igor-salt/DC36_DC5/README.md

Герберы для Резонита - в папке GERBERS, для JLCPCD - в папке production.
Перечень элементов для информации - в файле DC36_DC5.csv, для загрузки в Платан - в DC36_DC5_PL.csv.
Выгрузка заказа на 10 плат из корзины Платана - platan.xls.
В PNG - скриншоты пробных заказов комплестующих и плат в Платане, Резоните и JLCPCB.

1. При установке подстроечного резистора RV1, не устанавливаются элементы поз. R1 R2 и наоборот.

2. При использовании U1 в исполнении на фиксированное выходное напряжение, не устанавливаются
 элементы поз. R1, R2, RV1, C4, а на место R2 устанавливается перемычка.

3. Посадочные места элементов D1, D2 допускают установку подходящих по параметрам диодов в корпусах
DPAK, D2PAK, SMB, SMC; D4 - SMB, SMC.

4. Посадочные места элементов С2, С5 - допускают установку подходящих по параметрам конденсаторов
в корпусах 8 и 10 мм.

5. Посадочное место L1 позволяет устанавливать дроссели типоразмеров от 10х10 до 18х18.
