igor-salt/DC36_DC5/JLCPCB.PNG

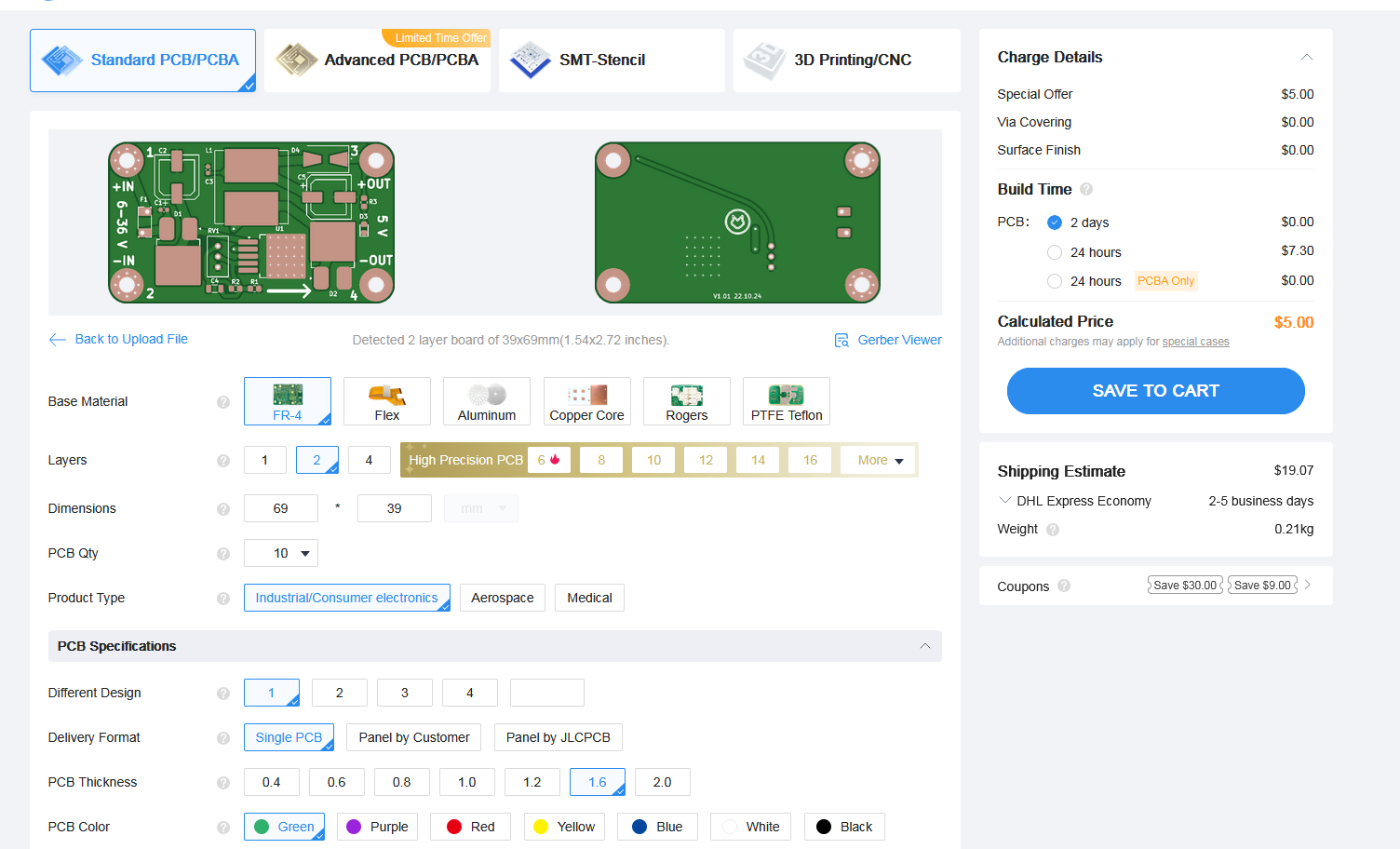
JLCPCB.PNG
