igor-salt/DC36_DC5/photo_2024-10-22_12-28-45.jpg

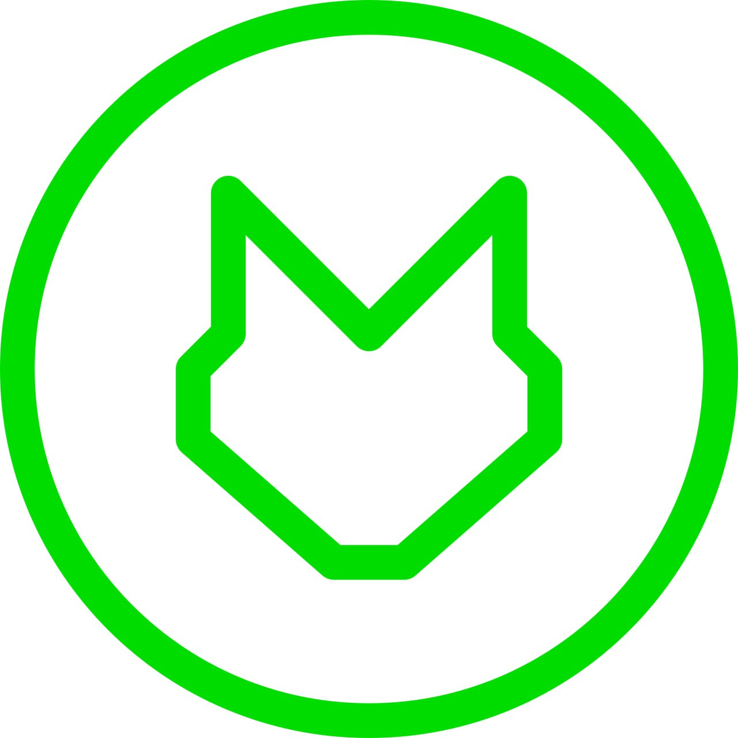
photo_2024-10-22_12-28-45.jpg
