igor-salt/DC36_DC5/Platan.PNG

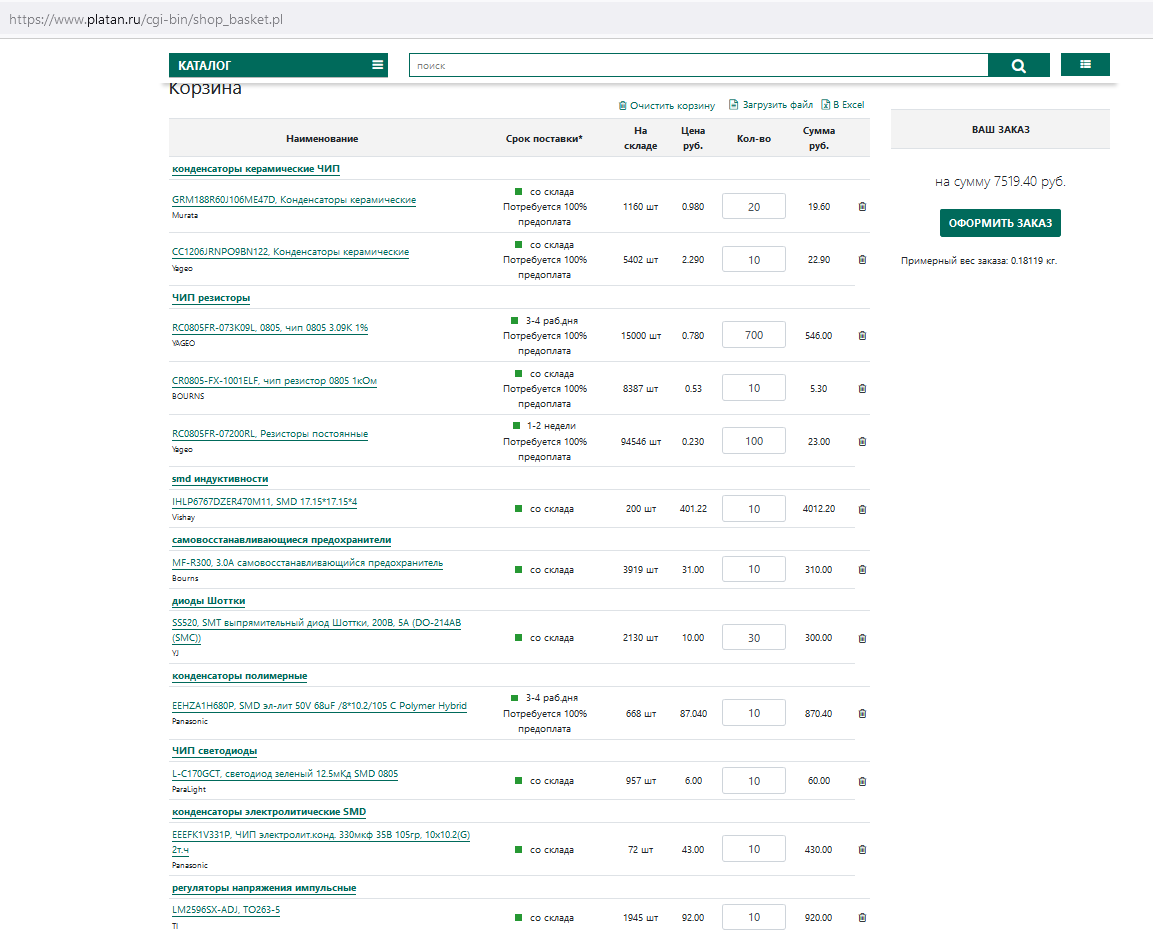
Platan.PNG
