igor-salt/DC36_DC5/rezonit.PNG

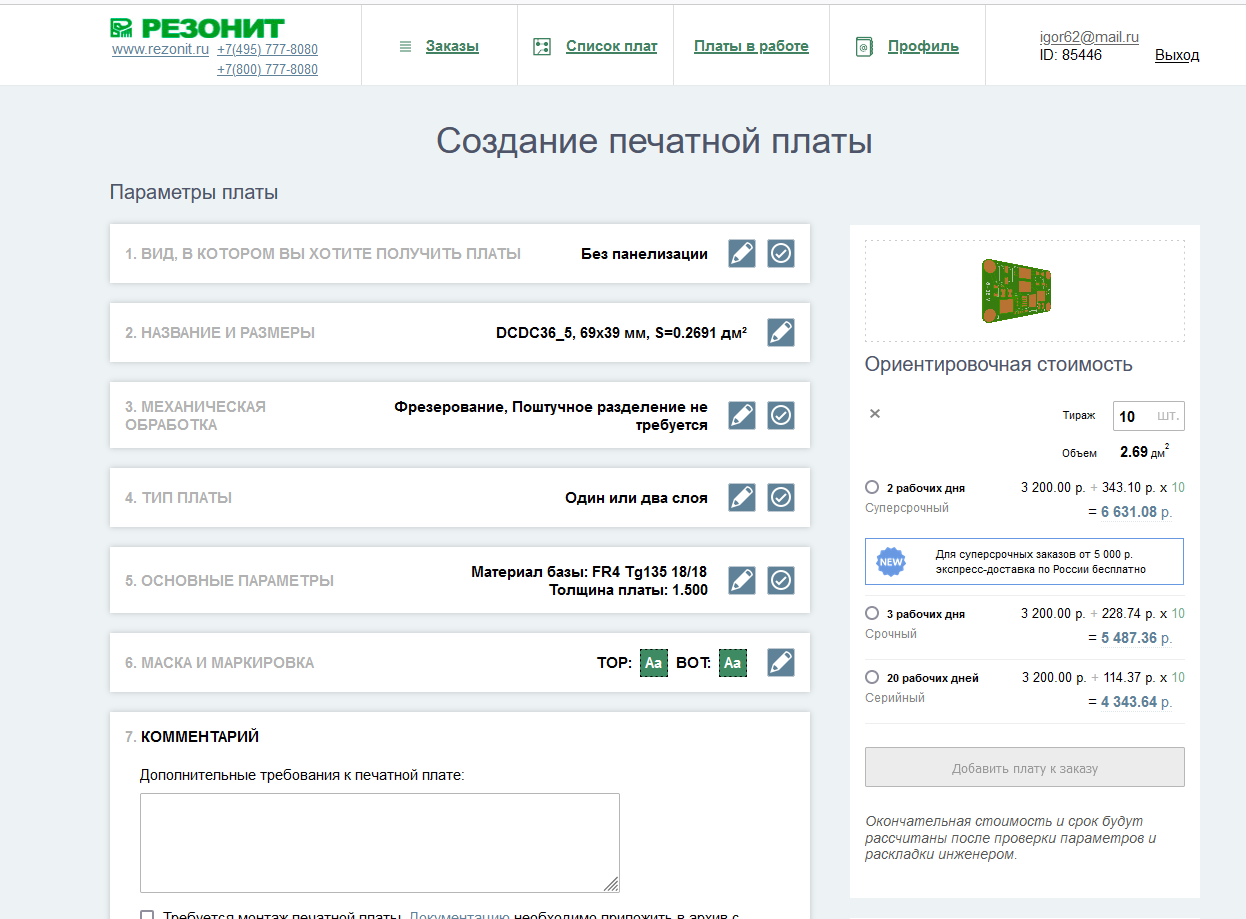
rezonit.PNG
