igor-salt/DC36_DC5/DC36_DC5.pdf

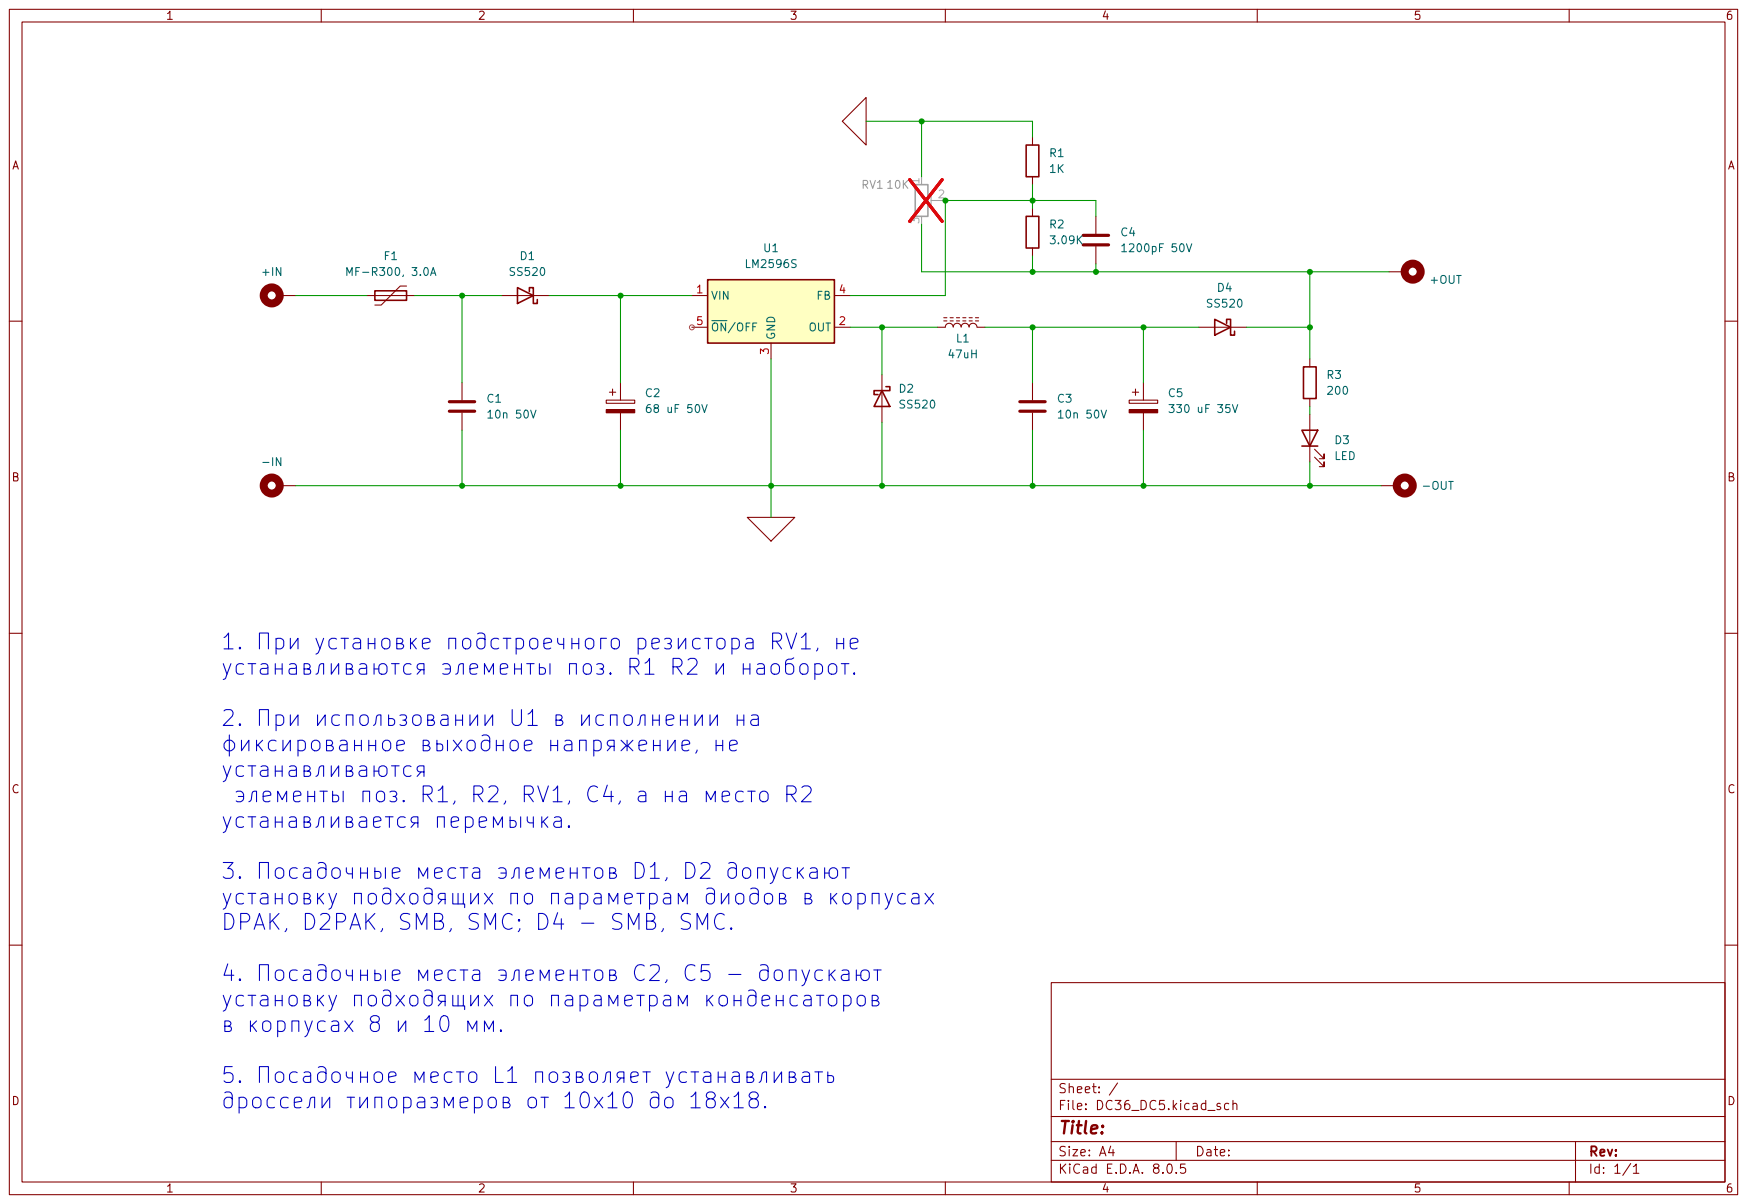
[picture p5: page 1]
