igor-salt/DC36_DC5/DC36_DC5.kicad_pcb

## KiCad design DC36_DC5.kicad_pcb (2024-10-22)

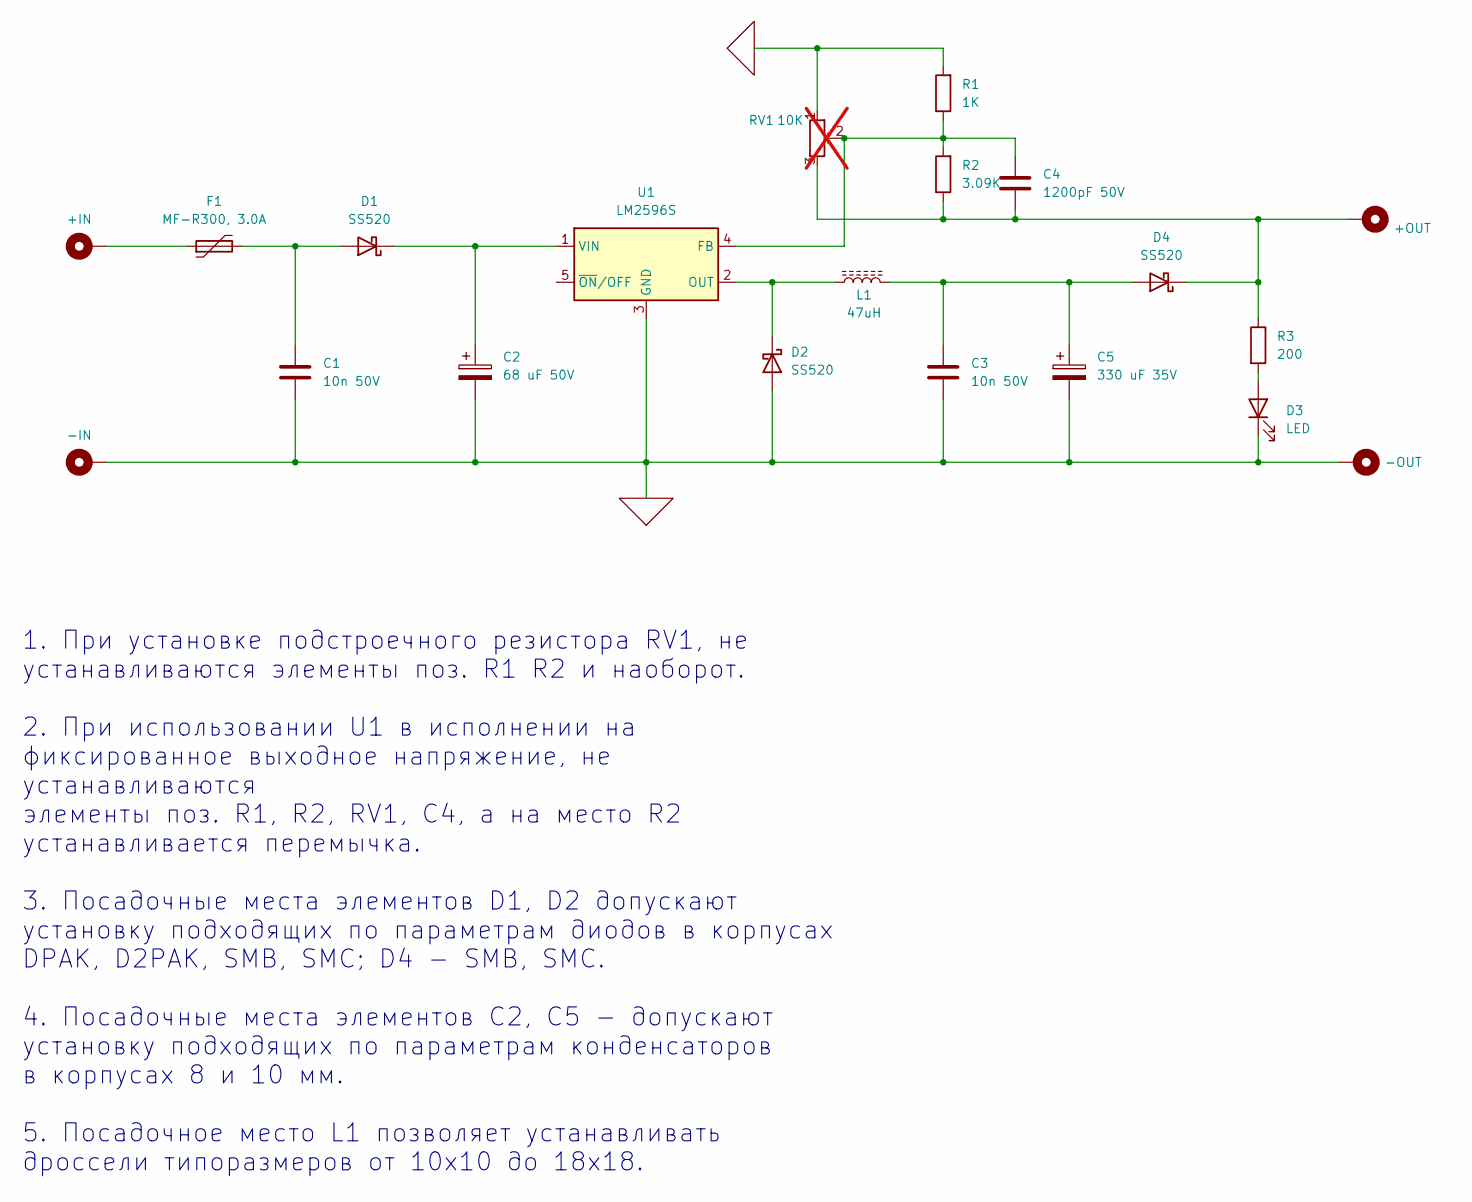
[picture p6: schematic DC36_DC5.kicad_sch]

Parts:
C1, C3: 10n 50V; C_0603_1608Metric
C2: 68 uF 50V; CP_Elec_8_10
C4: 1200pF 50V; C_1206_3216Metric
C5: 330 uF 35V; CP_Elec_8_10
D1, D2: SS520; DPAK_DDPAK
D3: LED; LED_0805_2012Metric_Pad1.15x1.40mm_HandSolder
D4: SS520; D_SMB-SMC_Universal_Handsoldering
F1: MF-R300, 3.0A; Fuse_Bourns_MF-R
H1: +IN; MountingHole_3.7x8mm_Pad_Via
H2: -IN; MountingHole_3.7x8mm_Pad_Via
H3: -OUT; MountingHole_3.7x8mm_Pad
H4: +OUT; MountingHole_3.7x8mm_Pad
L1: 47uH; L_10_12.7
R1: 1K; R_0805_2012Metric_Pad1.20x1.40mm_HandSolder
R2: 3.09K; R_0805_2012Metric_Pad1.20x1.40mm_HandSolder
R3: 200; R_0805_2012Metric_Pad1.20x1.40mm_HandSolder
RV1: 10K; Potentiometer_Bourns_3296W_Vertical; not fitted
U1: LM2596S

Connections:
unnamed: C1.1, D1.2 (A), F1.2
unnamed: C2.1, D1.1 (K), U1.1 (VIN)
unnamed: D2.1 (K), L1.1, U1.2 (OUT)
unnamed: D3.2 (A), R3.2
unnamed: C3.1, C5.1, D4.2 (A), L1.2
unnamed: C4.1, D4.1 (K), H4.1, R2.1, R3.1, RV1.3
unnamed: F1.1, H1.1
unnamed: C4.2, R1.1, R2.2, RV1.2, U1.4 (FB)
P,GND: C1.2, C2.2, C3.2, C5.2, D2.2 (A), D3.1 (K), H2.1, H3.1, R1.2, RV1.1, U1.3 (GND)

Notes on the sheet:
1. При установке подстроечного резистора RV1, не устанавливаются элементы поз. R1 R2 и наоборот. 2. При использовании U1 в исполнении на фиксированное выходное напряжение, не устанавливаются элементы поз. R1, R2, RV1, C4, а на место R2 устанавливается перемычка. 3. Посадочные места элементов D1, D2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

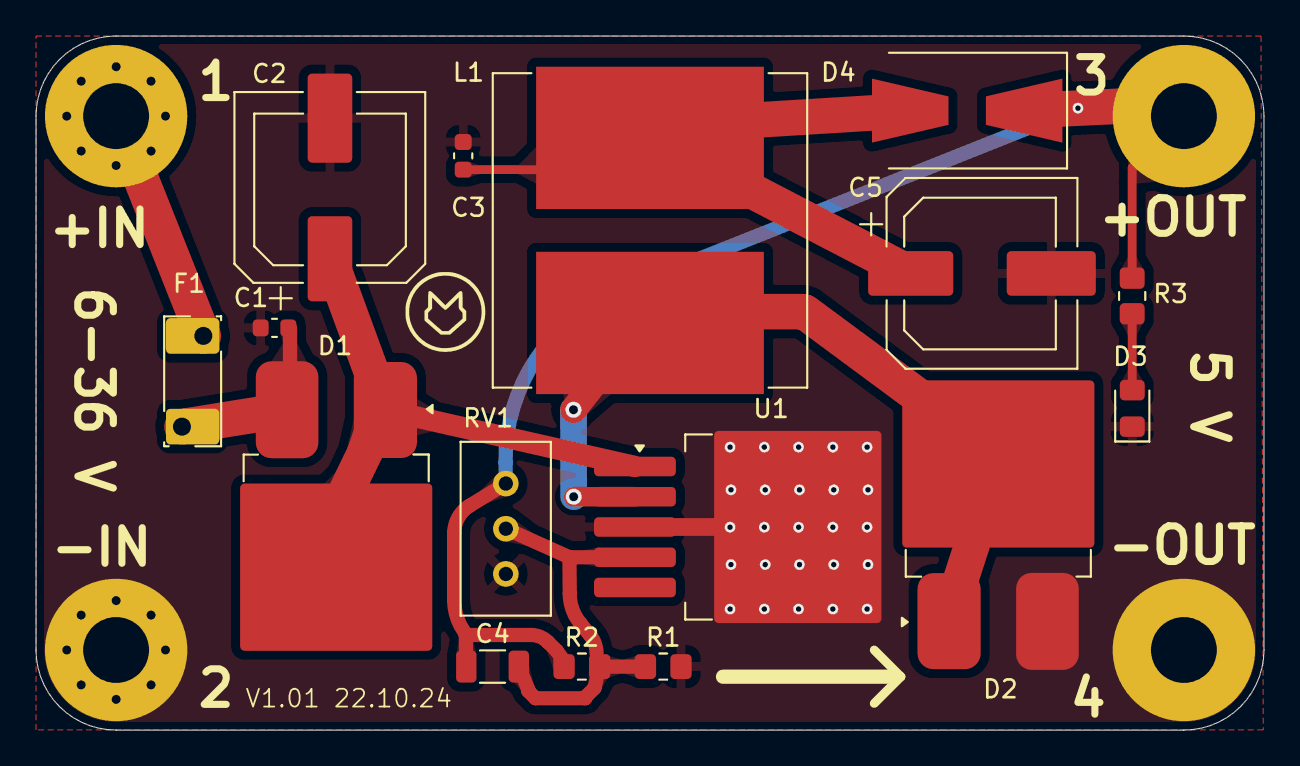
[picture p7: board DC36_DC5.kicad_pcb from above]

Board: 2 copper layers, 69.0 x 39.0 mm, 21 parts (0 on the bottom side), 9 nets.

Other parts of the board:
ARROW: ARROW
