igor-salt/DC36_DC5/(commit log)

2024-10-21 Ver 1.0
    [DC36_DC5-B_Cu.gbr, DC36_DC5-B_Mask.gbr, DC36_DC5-B_Paste.gbr, DC36_DC5-B_Silkscreen.gbr, DC36_DC5-Edge_Cuts.gbr, DC36_DC5-F_Cu.gbr, DC36_DC5-F_Mask.gbr, DC36_DC5-F_Paste.gbr]
2024-10-22 Add dtscription
    [DC36_DC5.csv, DC36_DC5.kicad_sch, DC36_DC5_PL.csv]
2024-10-22 To prod
    [DC36_DC5-B_Cu.gbr, DC36_DC5-B_Mask.gbr, DC36_DC5-B_Paste.gbr, DC36_DC5-B_Silkscreen.gbr, DC36_DC5-Edge_Cuts.gbr, DC36_DC5-F_Cu.gbr, DC36_DC5-F_Mask.gbr, DC36_DC5-F_Paste.gbr]
